RemiXNava98/feeder-SAE6-IOM-01/(list of files, drawings)

Other design files:
Feeder_CNC/Feeder_Fritzing.fzz
